bio-h/BHA_SyringePump/README.md

#BHA SyringePump

This repo contains the designs and source files of a **DIY Syringe Pump**. This device can be used to slowly pump a small amount of liquid. Check out the corresponding [BHA lecture in the Syllabus](http://biohackacademy.github.io) for more information.

##Navigation the repo

 	BHA_SyringePump/					main repo
 	|-- Arduino Code/SyringePump/		Arduino Code
 	|-- Pictures/						Photo documentation
 	BoM.md								Bill of Materials
 	SyringePump-Cut-Sheet.svg			Laser cut vector file
 	SyringePump-Fritzing.fzz				Wiring Scheme
 	SyringePump-Sketchup.skp				Sketchup 3D design
 	
##Releases

The BioHack Academy 3 release contains the following:

* 2015 BHA1 Design
* 2015 BHA2 Design
* 2016 BHA3 Design

## To Do

* BioHack Board wiring scheme
* Conversion rpm to volume / min

Please maket more suggestions by posting in the Issues section of this GitHub Repo.

## License

All code is licensed under GNU General Public License.

All designs are licensed under Creative Commons Contribution Share-Alike license

Copyright Waag Society
