bio-h/BHA_SyringePump/BoM.md

## Bill of Materials

Make sure you have an Arduino or equivalent microprocessor, big enough sheets of 3mm material to cut the design from and plenty of wires and M3 10 screws and nuts to assemble all the parts.

You will also need: 

* 60 mL syringe, make sure you adjust the mount according to the dimensions of your syringe!!

### Components that are needed to assemble everything on a breadboard

|No|Amount|Description|Supplier NL|Cost|
| ---: | ---: | :--- | :--- | ---: |
|1|1|NEMA17 Stepper motor|[RepRapWorld](http://reprapworld.com/?products_details&products_id=94&cPath=1614)|12.50|
|2|1|Pololu Stepper Driver|[RepRapWorld](http://reprapworld.com/?products_details&products_id=356)|11.99
|3|1|8mm smooth rod|[RepRapWorld](http://reprapworld.com/?products_details&products_id=342&cPath=1655)|2.99|
|4|2|LM8UU Linear Bearings|[RepRapWorld](http://reprapworld.com/?products_details&products_id=151&cPath=1655)|1.99|
|5|1|Axis coupling|[RepRapWorld](http://reprapworld.com/?products_details&products_id=417&cPath=1655)|1.99|
|6|1|M5 threaded rod|[RepRapWorld](http://reprapworld.com/?products_details&products_id=394&cPath=1595_1638)|2.15|
|7|3|Hexagonal M5 nut|[RepRapWorld](http://reprapworld.com/?products_details&products_id/850/cPath/1595_1597_1636_1712)|0.09|
|8|1|100 uF capacitor|[RepRapWorld](http://reprapworld.com/?products_details&products_id=45&cPath=1591_1600_1603), [Farnell](http://nl.farnell.com/panasonic-electronic-components/eeufr1c101/cap-alu-elec-100uf-16v-rad/dp/1907228)|0.20|
|9|1|Rotary encoder|[Farnell](http://nl.farnell.com/alps/ec12e1240406/encoder-vertical-12mm-12det-12ppr/dp/2065052), [iPrototype](https://iprototype.nl/products/components/buttons-switches/rotary-encoder), [EOO](http://www.eoo-bv.nl/index.php?_a=viewProd&productId=9553)|0.42|
|10|1|Knob|[Farnell](http://nl.farnell.com/multicomp/cr-r4-7/knob-soft-touch-d-shaft-black/dp/1440012?ost=1440012)|0.23|
|11|2|10K resistor|[Farnell](http://nl.farnell.com/te-connectivity/cfr16j10k/resistor-carbon-10k-0-25w-5/dp/2329474), [EOO](http://www.eoo-bv.nl/index.php?_a=viewProd&productId=7016)|0.03|
|12|2|10nF capacitor|[Farnell](http://nl.farnell.com/multicomp/mc0805y103m500a5-08mm/cap-mlcc-y5v-10nf-50v-rad/dp/2309024), [iPrototype](https://iprototype.nl/products/components/capacitors/capacitor-0.01-uf), [EOO](http://www.eoo-bv.nl/index.php?_a=viewProd&productId=5695)|0.14|
|13|2|100nF capacitor|[Farnell](http://nl.farnell.com/vishay/k104k15x7rf53h5/cap-mlcc-x7r-100nf-50v-rad/dp/1141777), [EOO](http://www.eoo-bv.nl/index.php?_a=viewProd&productId=13443)|0.14|
|14|1|12V 5A Power supply|[Farnell](http://nl.farnell.com/ideal-power/jyh32-1205000/adaptor-ac-dc-desktop-12v-5a/dp/2532631), [EOO](http://www.eoo-bv.nl/index.php?_a=viewProd&productId=13247)|38.13|
|15|4|Rubber feet|[Conrad](https://www.conrad.nl/nl/toolcraft-elastische-buffer-zelfklevend-pd2104sw-x-h-10-mm-x-4-mm-zwart-1-stuks-401489.html)|0.08|
|16|1|I2C LCD display|[iPrototype](https://iprototype.nl/products/components/led-lcd/lcd16x2-I2C-BL), [Hackerstore](https://www.hackerstore.nl/Artikel/82)|8.95|
|17|1|Breadboard|[Farnell](http://nl.farnell.com/pro-signal/psg-bb-400/breadboard-400-pin-white/dp/2503765). [iPrototype](https://iprototype.nl/products/accessoires/breadboards-prints/halfbreadboard)|2.56|

*Estimate total*: EUR 84.58

### Components that are needed on top of the Biohack Board

|No|Amount|Description|Supplier NL|Cost|
| ---: | ---: | :--- | :--- | ---: |
|1|1|NEMA17 Stepper motor|[RepRapWorld](http://reprapworld.com/?products_details&products_id=94&cPath=1614)|12.50|
|2|1|Pololu Stepper Driver|[RepRapWorld](http://reprapworld.com/?products_details&products_id=356)|11.99
|3|1|8mm smooth rod|[RepRapWorld](http://reprapworld.com/?products_details&products_id=342&cPath=1655)|2.99|
|4|2|LM8UU Linear Bearings|[RepRapWorld](http://reprapworld.com/?products_details&products_id=151&cPath=1655)|1.99|
|5|1|Axis coupling|[RepRapWorld](http://reprapworld.com/?products_details&products_id=417&cPath=1655)|1.99|
|6|1|M5 threaded rod|[RepRapWorld](http://reprapworld.com/?products_details&products_id=394&cPath=1595_1638)|2.15|
|7|3|Hexagonal M5 nut|[RepRapWorld](http://reprapworld.com/?products_details&products_id/850/cPath/1595_1597_1636_1712)|0.09|
|8|1|100 uF capacitor|[RepRapWorld](http://reprapworld.com/?products_details&products_id=45&cPath=1591_1600_1603), [Farnell](http://nl.farnell.com/panasonic-electronic-components/eeufr1c101/cap-alu-elec-100uf-16v-rad/dp/1907228)|0.20|
|9|1|Rotary encoder|[Farnell](http://nl.farnell.com/alps/ec12e1240406/encoder-vertical-12mm-12det-12ppr/dp/2065052), [iPrototype](https://iprototype.nl/products/components/buttons-switches/rotary-encoder), [EOO](http://www.eoo-bv.nl/index.php?_a=viewProd&productId=9553)|0.42|
|10|1|Knob|[Farnell](http://nl.farnell.com/multicomp/cr-r4-7/knob-soft-touch-d-shaft-black/dp/1440012?ost=1440012)|0.23|
|11|1|12V 5A Power supply|[Farnell](http://nl.farnell.com/ideal-power/jyh32-1205000/adaptor-ac-dc-desktop-12v-5a/dp/2532631), [EOO](http://www.eoo-bv.nl/index.php?_a=viewProd&productId=13247)|38.13|
|12|4|Rubber feet|[Conrad](https://www.conrad.nl/nl/toolcraft-elastische-buffer-zelfklevend-pd2104sw-x-h-10-mm-x-4-mm-zwart-1-stuks-401489.html)|0.08|
|13|1|I2C LCD display|[iPrototype](https://iprototype.nl/products/components/led-lcd/lcd16x2-I2C-BL), [Hackerstore](https://www.hackerstore.nl/Artikel/82)|8.95|

*Estimate total*: EUR 81.71
