bio-h/BHA_SyringePump/(list of files, cad)

Other CAD files:
SyringePump-Sketchup.skp
