bio-h/BHA_SyringePump/(list of files, drawings)

Other design files:
SyringePump-Fritzing.fzz
