bio-h/BHA_SyringePump/(commit log)

2015-03-24 * Copy from previous repository * Add button hole, extra screw holes, arduino uno power connector cutout * Create holder for rotary encoder * Arduino code (work in progress)
    [Syringe-Pump-Sketchup.skp]
2015-03-25 Something changed..
    [Syringe-Pump-Sketchup.skp]
2015-03-25 * push button in arduino code
2015-03-25 Link to documentation
    [Syringe-Pump-Sketchup.skp, Syringe-Pump-Sketchup~.skp]
2015-04-02 assembly photos
    [Syringe-Pump-Sketchup.skp]
2015-04-06 protocol for chaining devices
2015-04-06 update device chaining syntax
2015-04-12 * remove serial chaining code * change 'sp' serial command to 'move' (used by bioreactor)
2015-04-14 fixed communication and libraries in separate folder
    [SyringePump.ino]
2015-04-23 wiring including debounce circuit
    [Syringe-Pump-Fritzing.fzz]
2015-06-30 Archive BHA1
    [Syringe-Pump-Fritzing.fzz, Syringe-Pump-Sketchup.skp]
2015-09-09 BoM Update
2015-09-09 Syringe Pump clean up
    [Syringe-Pump-Sketchup.skp, Syringe-Pump-Sketchup~.skp]
2016-02-10 updating pins
    [Syringe-Pump-Fritzing.fzz]
2016-02-16 updated BoM for BioHackBoard
2016-03-06 SVG export
    [Syringe-Pump-Sketchup.skp]
2016-11-11 clean up old versions
    [Syringe-Pump-Fritzing.fzz, Syringe-Pump-Sketchup.skp]
2016-11-25 removed mosfet code
2016-12-16 BHA4 update
    [Syringe-Pump-Fritzing.fzz, Syringe-Pump-Sketchup.skp, SyringePump-Fritzing.fzz, SyringePump-Sketchup.skp]
2017-02-20 update schematic in .fzz
    [SyringePump-Fritzing.fzz]
