bio-h/BHA_SyringePump/(notices)

Notices in the files:
Arduino Code/SyringePump/SyringePump.ino:
General Public License as published by the Free Software
